bemxgm/Radon-Monitor/README.md

# Radon-Monitor

Opens Source Radon monitor

UNDER DEVELOPMENT

Authors
  The project is under development with the collaboration of the KTH, University of Stockholm, and Sapienza, University of Rome. 
  The authors are:
    -Luca Gugliermetti (luca.gugliermetti@uniroma1.it)
    -Massimiliano Colarieti Tosti (massimiliano.colarieti-tosti@sth.kth.se)
    -Luigi Lepore (luigi.lepore@uniroma1.it)
    -Romolo Remetti (romolo.remetti@uniroma1.it)

The Project
  The aim is to develop a cheap open source Radon Monitor able to detecct alpha particles from Radon and its doughters. 
  The system can be used paired with a MCU chip (Microcontrollers, such as Arduino) to take the readings or used with a 
  standard MCA (Multi Channel Analyzer) and a 5V to 12V amplifier to precisely analyze the alpha spectre with professional 
  instrumentation.

Shemetics
  The schematis are avaiable in MULTISIM format or as Gerber files ready to be printed. 
  
BOM
  The folder "BOM" contain the list with costs of the components.

Code
  The folder "Code" contains the code used for the system, for arduino or other MCU. It is avaiable also a compotuer dataloggher 
  written in python.

Acknowledgments

The present research has been developed within the project ‘PRACTICE’ (Planning Re-thinked Ageing Cities Through Innovative CellularEnvironments), financed under a cooperation framework between theRepublic of Italy and the Kingdom of Sweden, and carried out bySapienza - University of Rome and the Royal Institute of Technology ofStockholm, KTH. The authors desire also to thank the Dynamic Makersteam for their support. 
The board has been made with a Cirqoid CNC (https://cirqoid.com/). 

License
  The Project is under GNL 3.0 license (https://opensource.org/licenses/GPL-3.0) and the authors shall be cited in the further works.
