bemxgm/Radon-Monitor/Theory/Calculus .xlsx

Sheet: Diode
Photodiode
 |  |  |  |  |  |  |  | Hamamatsu S1723-06
 |  |  |  |  |  |  |  | Material |  | Ceramic
 |  |  |  |  |  |  |  | Effective area |  | 100 | mm2
 |  |  |  |  |  |  |  | Peak wawelenght |  | 900 | nm
 |  |  |  |  |  |  |  | Sensitivity on peak |  | 0.6 | A/W
 |  |  |  |  |  |  |  | Icc |  | 80 | uA
 |  |  |  |  |  |  |  | Dark current 30V -25°C |  | 5 | nA
 |  |  |  |  |  |  |  | Temp. Dipend. Dark current |  | 1.15 | Times/C°
 |  |  |  |  |  |  |  | Junction capacitance 30V |  | 100 | pF
 |  |  |  |  |  |  |  | Vmax reverse |  | 50 | V
 |  |  |  |  |  |  |  | R shunt | exp | 1129.944 | Mohm
 |  |  |  |  |  |  |  | Rcontact | exp | 1 | ohm
ε0 |  | 8.85e-14 | F/cm | electrical permittivity in space |  |  |  | Va | V bias | 0 | V
εSi |  | 11.9 |  | // in silicium |  |  |  | Vinternal |  | 0.4605 | V
μ |  | 1400 | cm2/V s | mobility of electrons at 300K
ρ | supposed | 3821.631782 | ohm/cm | Si resistivity |  |  |  | I photolight |  | 3.518379858e-07 | A
Ws | supposed | 0.02500002495 | cm | at Wd at Vmax+10%
thickness of substrate
Wd |  | 0.002278050614 | at V bias = 0
Depletion region width |  |  |  |  |  |  |  | C junction capacitance
 |  |  |  |  |  |  |  | point from graph (2V) |  | 200 | pF
 |  |  |  |  |  |  |  | Wd from graph |  | 0.00526575 | cm
 |  |  |  |  |  |  |  | ρ |  | 3821.631782 | ohm/cm
 |  |  |  |  |  |  |  | Cj | Vbias = 0 | 462.3031612 | pF
Rs | 87.83501927 | ohm
DARK CURRENT & SAT CURRENT
Isat | sat current | -5 | nA | V bias dark current |  | -30
 |  |  |  |  |  |  | V
kb | boltzmann | 1.38064852e-23 | J/K | 8.617330342e-05 | eV/K
T | Kelvin cond standard | 298.15 | K
q | electron charge | 1.60217662e-19 | C |  |  |  |  |  |  |  |  | NOISE
Thermal voltage |  | 0.02569257041 | V |  |  |  |  |  |  |  |  | johnson noise
Id | actual voltage | 0 | nA
Lux test Icc | 100 | lux | 0.01666666667 | W |  |  |  |  |  |  |  | f | supposed | 1000 | kHz | noise bandwidth
Isat |  |  |  |  |  |  |  |  |  |  |  | Ij | 3.817337056 | pA
 |  |  |  |  |  |  |  |  |  |  |  | shot noise
 |  |  |  |  |  |  |  |  |  |  |  | Isn | 0.335769741 | pA
open circuit V |  | 0.4319240415 | V | not valid for low light |  |  |  |  |  |  |  | total noise
 | I light | 0.1 | A |  |  |  |  |  |  |  |  | It | 3.832075615 | pA
Quantum EFFICIENCY |  |  |  |  |  |  |  |  |  |  |  | noise % | 0.00109%
λ | 550 | CsI
Sensitivity | 0.3 | A/W
QE | 0.6763636364 | -
fraction of the incident photons that contribute to photocurrent
En incident |  | 1.172793286e-06
photons interacted |  | 32944.2037 | -
En absorbed |  | 1.189852097e-14 | J
rise time |  | 15 | ns
50 ohm
Current produced |  | 3.518379858e-07 | A

Sheet: Setup1
Light pulse |  |  |  | Noise |  |  |  |  | constants
Radon | 5.49 | Mev |  | johnson noise |  |  |  |  | q | 1.60217662e-19 | C
QE anthracene | 2000 | photons/MeV |  | T |  | 298.15 | K |  | kb | 1.38064852e-23 | J/K
%specific | 0.45 |  |  | R shunt |  | 38000 | Mohm |  | h plank | 4.135667e-15 | eV s
λ scintillator | 580 | nm |  | I js |  | 2.081599477e-17 | A/Hz-0,5 |  | c light | 299792458 | m/s
En photon | 2.137658233 | eV |  | shot noise |  |  |  |  | ε0 | 8.85e-12 | F/m | electrical permittivity in space
Energy transmitted | 1.692246076e-15 | J |  | I dark current datasheet |  | 2e-12 | A |  | εSi | 11.9 |  | // in silicium
decay time | 17.7 | ns |  | at V |  | 5 | V |  | μ | 0.14 | m2/V s | mobility of electrons at 300K
freq scintillator | 56.49717514 | MHz |  | at T |  | 25 | °C
light power | 9.560712293e-08 | W |  | Isat |  | 6.074451191e-97 | A
 |  |  |  | V bias |  | 2e-05 | V
Light intensity |  |  |  | I dark current |  | 4.730407266e-100 | A
tot light power | 9.560712293e-08 | W |  | I from light |  | 8.126605449e-08 | A |  | Diode model |  | BPW21R
Sensitivity | 0.85 | A/W |  | I n dark |  | 1.231174068e-59 | A/Hz-0,5 |  | Amp model |  | AD8605
I from light | 8.126605449e-08 | A |  | I n photo |  | 1.613707362e-13 | A/Hz-0,5
 |  |  |  | I n shot |  | 1.613707362e-13 | A/Hz-0,5
 |  |  |  | total noise
 |  |  |  | I n |  | 1.613707375e-13 | A/Hz-0,5
Amplification
Rf | 50 | Mohm
V end low freq (ideal) | 4.063302725 | V |  | Rise and fall Time
gain | 50000000 |  |  | t diode> t amp
 |  |  |  | Diode model |  |  | BPW21R
 |  |  |  | t rise |  | 3.1e-06 | s
noise gain |  |  |  | t fall |  | 3e-06 | s
1/β0 |  | 1.001315789 | V/V | min freq diode |  | 327868852.5 | kHz
diode capacity |  | 1376.82685 | pF | Amp model
Common-Mode Input Capacitance |  | 8.8 | pF | Slew Rate |  | 1e-06 | s
Differential Input Capacitance |  | 2.6 | pF | Settling Time |  | 1e-06 | s
C feedback |  | 200 | pF
1/βi |  | 7.941134248 | V/V | Diode capicitance
unity gain bandwidth |  | 10 | MHz | capacitance at V |  | 400 | pF
f p |  | 9.947183943 | Hz | V | datasheet | 5 | V
fz |  | 2.006821098 | Hz | Wd |  | 1.97465625e-06 | m
f x |  | 1259.265955 | kHz | Diode area |  | 7.5 | mm2
johnson noise feedback |  | 5.738573734e-16 | A/Hz-0,5 | Open circuit V |  | 450 | mV | (min 280)
Input offset current |  | 0.10 | pA | ρ | Si resistivity | 0.02426265052 | ohm/m
shot noise |  | 1.790070736e-16 | A/Hz-0,5 | operative voltage |  | 10 | mV
current noise |  | 6.01128786e-16 | A/Hz-0,5 | Wd | operative V | 5.736832487e-07 | m
Voltage Noise Density | 1 kHz | 8 | nV/Hz-0,5 | Cj | operative V | 1376.82685 | pF
 | 10 kHz | 6.5 | nV/Hz-0,5
e noise voltage |  | 6.352907399e-08 | V/Hz-0,5
e noise thermal |  | 2.869286867e-08 | V/Hz-0,5
e noise resistor |  | 8.95035368e-09 | V/Hz-0,5
Current Noise Density | 1 kHz | 0.01 | pA/Hz-0,5
e noise current |  | 1.001315789e-14 | V/Hz-0,5
e tot |  | 7.028038692e-08 | V/Hz-0,5
E voltage |  | 2.814291611e-06 | V rms
E thermal |  | 1.271073141e-06 | V rms
E resistor |  | 3.964941356e-07 | V rms
E current |  | 4.435755867e-13 | V rms
peak to peak noise |  | 2.3 | uV p-p
TOTAL NOISE |  | 3.113369846e-06 | V rms
PEAK NOISE |  | 7.160750647e-06 | V p-p

Sheet: Setup2
Light pulse |  |  |  | Noise |  |  |  |  | constants
Radon | 5.49 | Mev |  | johnson noise |  |  |  |  | q | 1.60217662e-19 | C
QE anthracene | 1730.769231 | photons/MeV |  | T |  | 298.15 | K |  | kb | 1.38064852e-23 | J/K
%specific | 0.5 |  |  | R shunt |  | 38000 | Mohm |  | h plank | 4.135667e-15 | eV s
λ scintillator | 580 | nm |  | I js |  | 2.081599477e-17 | A/Hz-0,5 |  | c light | 299792458 | m/s
En photon | 2.137658233 | eV |  | shot noise |  |  |  |  | ε0 | 8.85e-12 | F/m | electrical permittivity in space
Energy transmitted | 1.627159688e-15 | J |  | I dark current datasheet |  | 2e-12 | A |  | εSi | 11.9 |  | // in silicium
decay time | 34.5 | ns |  | at V |  | 5 | V |  | μ | 0.14 | m2/V s | mobility of electrons at 300K
freq scintillator | 28.98550725 | MHz |  | at T |  | 25 | °C
light power | 4.716404894e-08 | W |  | Isat |  | 6.074451191e-97 | A
 |  |  |  | V bias |  | 0.15 | V
Light intensity |  |  |  | I dark current |  | 2.078573558e-94 | A
tot light power | 4.716404894e-08 | W |  | I from light |  | 2.267353664e-10 | A |  | Diode model |  | BPW21R
Sensitivity | 0.85 | A/W |  | I n dark |  | 8.161178784e-57 | A/Hz-0,5 |  | Amp model |  | AD8605
I from light | 2.267353664e-10 | A |  | I n photo |  | 8.523732786e-15 | A/Hz-0,5
 |  |  |  | I n shot |  | 8.523732786e-15 | A/Hz-0,5
 |  |  |  | total noise
 |  |  |  | I n |  | 8.523758203e-15 | A/Hz-0,5
Amplification
Rf | 50 | Mohm
V end low freq (ideal) | 0.01133676832 | V |  | Rise and fall Time
gain | 50000000 |  |  | t diode> t amp
 |  |  |  | Diode model |  |  | BPW21R
 |  |  |  | t rise |  | 3.1e-06 | s
noise gain |  |  |  | t fall |  | 3e-06 | s
1/β0 |  | 1.001315789 | V/V | min freq diode |  | 327868852.5 | kHz
diode capacity |  | 1376.82685 | pF | Amp model
Common-Mode Input Capacitance |  | 8.8 | pF | Slew Rate |  | 1e-06 | s
Differential Input Capacitance |  | 2.6 | pF | Settling Time |  | 1e-06 | s
C feedback |  | 200 | pF
1/βi |  | 7.941134248 | V/V | Diode capicitance
unity gain bandwidth |  | 10 | MHz | capacitance at V |  | 400 | pF
f p |  | 9.947183943 | Hz | V | datasheet | 5 | V
fz |  | 2.006821098 | Hz | Wd |  | 1.97465625e-06 | m
f x |  | 1259.265955 | kHz | Diode area |  | 7.5 | mm2
johnson noise feedback |  | 5.738573734e-16 | A/Hz-0,5 | Open circuit V |  | 450 | mV | (min 280)
Input offset current |  | 0.10 | pA | ρ | Si resistivity | 0.02426265052 | ohm/m
shot noise |  | 1.790070736e-16 | A/Hz-0,5 | operative voltage |  | 10 | mV
current noise |  | 6.01128786e-16 | A/Hz-0,5 | Wd | operative V | 5.736832487e-07 | m
Voltage Noise Density | 1 kHz | 8 | nV/Hz-0,5 | Cj | operative V | 1376.82685 | pF
 | 10 kHz | 6.5 | nV/Hz-0,5
e noise voltage |  | 6.352907399e-08 | V/Hz-0,5
e noise thermal |  | 2.869286867e-08 | V/Hz-0,5
e noise resistor |  | 8.95035368e-09 | V/Hz-0,5
Current Noise Density | 1 kHz | 0.01 | pA/Hz-0,5
e noise current |  | 1.001315789e-14 | V/Hz-0,5
e tot |  | 7.028038692e-08 | V/Hz-0,5
E voltage |  | 2.814291611e-06 | V rms
E thermal |  | 1.271073141e-06 | V rms
E resistor |  | 3.964941356e-07 | V rms
E current |  | 4.435755867e-13 | V rms
peak to peak noise |  | 2.3 | uV p-p
TOTAL NOISE |  | 3.113369846e-06 | V rms
PEAK NOISE |  | 7.160750647e-06 | V p-p

Sheet: Sheet1
QE | 1.924137931 | elettroni/fotone
 | 625

Sheet: Scintillator
Working level |  | 0.37 | -
3700 Bq per WL |  | 3700* | Bq
1,3*10^5 MeV |  | 48100 | MeV | all'equilibrio
equilibrium factor indoor |  | 0.4
Energy |  | 19240 | MeV
Quantum efficieny scintillator α |  |  | 0.1
Radon | 5.49 | Mev |  |  | h plank | 4.135667e-15 | eV s
Assorbed | 549 | KeV |  |  | c light | 299792458 | m/s
λ scintillator | 550 | nm
En photon | 2.254257773 | eV
n photons | 243539.1402 | -
% transmitted | 0.2 | -
photons at diode | 48707.82805 | -
1 WL | = 130,000 MeV alpha energy per litre air'
 | = 20.8 microjoules (µJ) alpha energy per cubic meter (m3) air.
En for 100 Bq | 2:58:34 | mJ h m-3 | factor | 1 | (0.6 suggested)
 | 5.9e-07 | W m-3
chamber area | 1e-06 | m3 |  |  |  |  |  | Radon | 5.49 | Mev
1 on 6 face | 0.50 |  |  |  |  |  |  | QE | 2000 | photons/MeV
alfa energy |  |  |  |  |  |  |  | %specific | 0.45
 |  |  |  |  |  |  |  | λ scintillator | 580 | nm
 |  |  |  |  |  |  |  | En photon | 2.137658233 | eV
 |  |  |  |  |  |  |  | Energy transmitted | 10562.16933
optical | 50%
tot light power | 2.95e-10 | W m-3
