bemxgm/Radon-Monitor/BOM/cost.xlsx

Quantity | Description | RefDes | Package | Type | Obsolete | Vendor | Price total | Price | Hyperlink | Manufacturer | Manufacturer Part No. | Vendor Part No.
1 | RES_ThinFilm_0805_Vishay_TNPW, 1MΩ,±0.1% | R16 | Vishay\RESC2012X55N |  | No | Mouser | 0.851 | 0.851 | http://www.mouser.com/Search/ProductDetail.aspx?qs=1C6%2fyOstnVtWaiUXyfr2Kw%3d%3d | Vishay | TNPW08051M00BEEN | 71-TNPW08051M00BEEN
3 | RES_ThinFilm_0805_Susumu_RG, 1kΩ,±0.1% | R2, R5, R9 | Susumu\RESC2012X50N |  | No | Mouser | 1.455 | 0.485 | http://www.mouser.com/Search/ProductDetail.aspx?qs=juJhw1yPxAEQNCaGnCWiqg%3d%3d | Susumu | RG2012P-102-B-T5 | 754-RG2012P-102-B-T5
1 | RES_ThinFilm_0805_Panasonic_ERA, 10kΩ,±0.1% | R10 | Panasonic\RESC2012X60N |  | No | Mouser | 0.796 | 0.796 | http://www.mouser.com/Search/ProductDetail.aspx?qs=ob%252bdNz2%252bYEgh3%2fToXyv%2f%252bw%3d%3d | Panasonic | ERA-6ARB103V | 667-ERA-6ARB103V
1 | RES_Chip_2512_TT_Electronics_HVC, 40MΩ,±1% | R1 | Welwyn Components/TT electronics\RESC6532X80N |  | No | Mouser | 0.706 | 0.706 | http://www.mouser.com/Search/ProductDetail.aspx?qs=tjlMjqRIEYTRqB%2fqUNqyOQ%3d%3d | Welwyn Components / TT electronics | HVC2512-40MJT18 | 756-HVC2512-40MJT18
1 | RES_ThinFilm_0805_Panasonic_ERA, 100kΩ,±0.1% | R11 | Panasonic\RESC2012X60N |  | No | Mouser | 0.796 | 0.796 | http://www.mouser.com/Search/ProductDetail.aspx?qs=ob%252bdNz2%252bYEhtap3zex4MEw%3d%3d | Panasonic | ERA-6ARB104V | 667-ERA-6ARB104V
3 | RES_ThinFilm_0805_Panasonic_ERA, 47kΩ,±0.1% | R7, R8, R12 | Panasonic\RESC2012X60N |  | No | Mouser | 2.388 | 0.796 | http://www.mouser.com/Search/ProductDetail.aspx?qs=ob%252bdNz2%252bYEgjmNSnEIwTXQ%3d%3d | Panasonic | ERA-6ARB473V | 667-ERA-6ARB473V
1 | HEADER_PIN_Single_Row_Molex, 22-28-0040 | J1 | Molex\1x4pin_025pin |  | No | Mouser | 0.33 | 0.33 | http://www.mouser.com/Search/ProductDetail.aspx?qs=ZwgtpdmWYYRezY62LCkWPA%3d%3d | Molex | 22-28-0040 | 538-22-28-0040
10 | CAP_Ceramic_0805_10V_Kemet_X7R, 0.1µF,±5% | C2, C4, C5, C8, C9, C10, C11, C12, C15, C16 | KEMET\CAPC2012X100N |  | No | Mouser | 4.66 | 0.466 | http://www.mouser.com/Search/ProductDetail.aspx?qs=zZwvocWqSRjRMIheUubV0A%3d%3d | Kemet | C0805C104J8RACTU | 80-C0805C104J8R
1 | CAP_Ceramic_0805_16V_AVX_C0G, 100pF,±1% | C20 | AVX\CAPC2012X94N |  | No | Mouser | 0.375 | 0.375 | http://www.mouser.com/Search/ProductDetail.aspx?qs=dgFKbxv6TyLobXWx89sDVg%3d%3d | AVX | 0805YA101FAT2A | 581-0805YA101FAT2A
1 | CAP_Ceramic_0603_50V_Murata_GRM_C0G, 47pF,±1% | C23 | Murata Electronics\CAPC1608X87N |  | No | Mouser | 0.145 | 0.145 | http://www.mouser.com/Search/ProductDetail.aspx?qs=uFJkqF3uSG511JiOAsIRVA%3d%3d | American Technical Ceramics (ATC) | 600F470FT250XT | 581-600F470FT
1 | CAP_Ceramic_0603_50V_Murata_GRM_C0G, 47pF,±1% | C14 | Murata Electronics\CAPC1608X87N |  | No | Mouser | 0.145 | 0.145 | http://www.mouser.com/Search/ProductDetail.aspx?qs=uFJkqF3uSG511JiOAsIRVA%3d%3d | Murata Electronics | GRM1885C1H470FA01D | 81-GRM39C470F50
1 | CAP_Ceramic_0805_16V_AVX_X7R, 4.7µF,±10% | C6 | AVX\CAPC2012X152N |  | No | Mouser | 0.723 | 0.723 | http://www.mouser.com/Search/ProductDetail.aspx?qs=Xu68utgrSJ9i%2f1tFp89WMw%3d%3d | AVX | 0805YC475KAT2A | 581-0805YC475KAT2A
2 | CAP_Ceramic_0805_6_3V_Kemet_X5R, 47µF,±20% | C19, C21 | KEMET\CAPC2012X140N |  | No | Mouser | 1.592 | 0.796 | http://www.mouser.com/Search/ProductDetail.aspx?qs=K%2fj%2fqf%252b0fqK83CqPLzoIkg%3d%3d | Kemet | C0805C476M9PACTU | 80-C0805C476M9P
1 | CAP_Ceramic_0805_16V_AVX_C0G, 0.01µF,±1% | C13 | AVX\CAPC2012X152N |  | No | Mouser | 1.67 | 1.67 | http://www.mouser.com/Search/ProductDetail.aspx?qs=ZS1qrWEkmV4zM%2f%2fq%2fGV%252b1g%3d%3d | AVX | 0805YA103FAT2A | 581-0805YA103FAT2A
1 | PHOTODIODE_TO5_Vishay, BPW21R | D1 | Vishay Semiconductors\DIO7R5 |  | No | Mouser | 11.15 | 11.15 | http://www.mouser.com/Search/ProductDetail.aspx?qs=sRxRae9rBb2plOvKklAY5A%3d%3d | Vishay Semiconductors | BPW21R | 78-BPW21R
1 | RES_Chip_0805_Vishay_CRCW_PREC, 100MΩ,±5% | R15 | Vishay/Dale\RESC2012X50N |  | No | Mouser | 0.615 | 0.615 | http://www.mouser.com/Search/ProductDetail.aspx?qs=0F7%252bs%2f6yKlt4qWw3Cu3RBw%3d%3d | Vishay / Dale | CRCW0805100MJPEAHR | 71-CRCW0805-100M-E3
1 | CAP_Ceramic_0805_25V_Vishay_VJ_C0G, 18pF,±1% | C17 | Vishay/Vitramon\CAPC2012X145N |  | No | Mouser | 0.208 | 0.208 | http://www.mouser.com/Search/ProductDetail.aspx?qs=wtJBjE46HQsdloijp%2f5Pbw%3d%3d | Vishay / Vitramon | VJ0805A180FXXCW1BC | 77-VJ0805A180FXXCBC
1 | OPAMP, AD8608AR | U2 | Analog Devices\SOIC-N-14(R-14) |  | No | Mouser | 3.71 | 3.71 | http://www.mouser.it/ProductDetail/Analog-Devices/AD8608ARZ/?qs=sGAEpiMZZMv9Q1JI0Mo%2ftfr1Hn6Y%2fmas | Analog Devices
 |  |  |  |  |  |  | 32.315
