bemxgm/Radon-Monitor/(list of files, drawings)

Other design files:
Schematics/Radon monitor-definitive2.3.ms14
