bemxgm/Radon-Monitor/Theory/CalibrationT e H.xlsx

Temperatura (°C) |  |  | Umidità (%) |  |  | Rette di calibrazione per la temperatura (asse x: valori dallo strumento; asse y: valori dal termoigrometro)
Strumento | Termoigr. | Errore (%) | Strumento | Termoigr. | Errore (%)
23 | 23.7 | 2.95 | 25 | 25.3 | 1.19
23 | 24 | 4.17 | 28 | 27.1 | 3.32
23 | 24.1 | 4.56 | 35 | 31.5 | 11.11
23 | 24.2 | 4.96 | 35 | 30.7 | 14.01
24 | 24.2 | 0.83 | 37 | 32.4 | 14.20
24 | 23.3 | 3.00 | 39 | 35.2 | 10.80
24 | 23.4 | 2.56 | 39 | 37.3 | 4.56
31 | 29.6 | 4.73 | 42 | 39.2 | 7.14
31 | 29.7 | 4.38 | 42 | 39.9 | 5.26
32 | 30.9 | 3.56 | 43 | 43.4 | 0.92
33 | 33.5 | 1.49 | 44 | 42.5 | 3.53
35 | 35.8 | 2.23 | 45 | 44.8 | 0.45
37 | 34.8 | 6.32 | 51 | 49.6 | 2.82
37 | 37 | 0.00 | 67 | 71.3 | 6.03
RETTE DI TARATURA
TEMPERATURA |  |  | UMIDITÀ |  |  | Rette di calibrazione per l'umidità (asse x: valori dallo strumento; asse y: valori dal termoigrometro)
y = 0,906x + 2,550 |  |  | y = 1,126x - 6,738
dove:
x è la grandezza misurata con lo strumento
y è la temperatura che si stima venga misurata dal termoigrometro
NB: è stata scelta l'interpolazione con retta non passante per l'origine per prescindere da non
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
