bemxgm/Radon-Monitor/(threads)

Thread 1 (2020-02-28):

Development of a low-cost monitor for radon detection in air

Torgrima, 2020-02-28:
There is a Arduino project, in the prototype thy use an inexpensive sensor. The SLCD-61N5 Si-PIN planar photodiode, sensitive to alpha particles. That might be of interest to any one planing to build a Radon sensor.

**Abstract of the article linked below:**
An active device for radon detection in the air was developed. The monitor operates in pulse
counting mode for real-time continuum measurements. The presented prototype has a relatively simple design made of low-price and easy to acquire components which made it possible to develop an inexpensive device. The device uses as sensor the SLCD-61N5 Si-PIN planar photodiode, which has an area of 9.67×9.67 mm2 , sensitive to alpha particles. An Arduino Uno microcontroller was used as data acquisition system. Signals were observed when placing an 241Am or 226Ra source near the sensor.

The sensor's sensitivity has small bias dependency and the device can operate even at modest voltage.

As a result of a one-month test in a rich radon atmosphere, a positive high correlation was obtained
between our prototype and a Geiger-Müller detector.

[https://arxiv.org/ftp/arxiv/papers/1907/1907.08143.pdf](https://arxiv.org/ftp/arxiv/papers/1907/1907.08143.pdf)

Thread 2 (2023-06-14):

Missing Gerber Files

odmarkj, 2023-06-14:
Hello, it appears some Gerber files are missing, such as the schema and drill files. Would it be possible to have those added or sent to me so I can add them? Even if you only have the design files from whichever program was used to create the PCB, I can create the necessary files.

Thank you!
